mguentner/gaggia-cortex/case/ssr-cover.stl

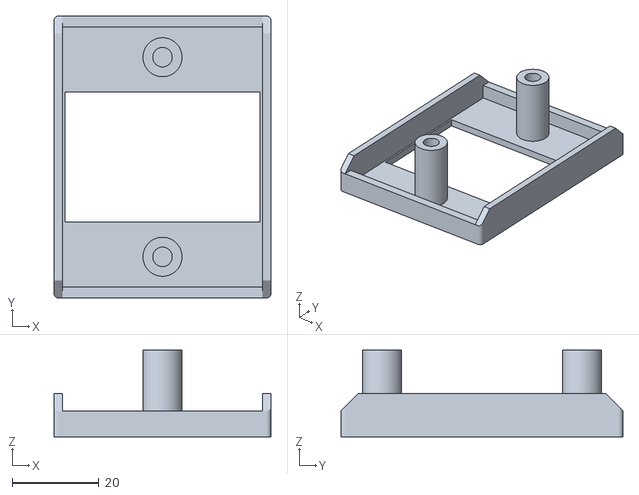
[picture p3: CAD file, 2024-03-08]
case/ssr-cover.stl
50.0 x 65.0 x 20.0
