mguentner/gaggia-cortex/case/case-Top.stl

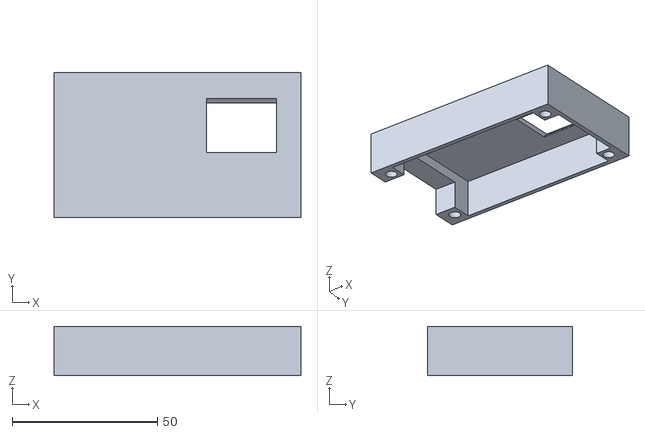
[picture p4: CAD file, 2024-03-08]
case/case-Top.stl
85.0 x 50.0 x 17.0
