mguentner/gaggia-cortex/case/case-Base.stl

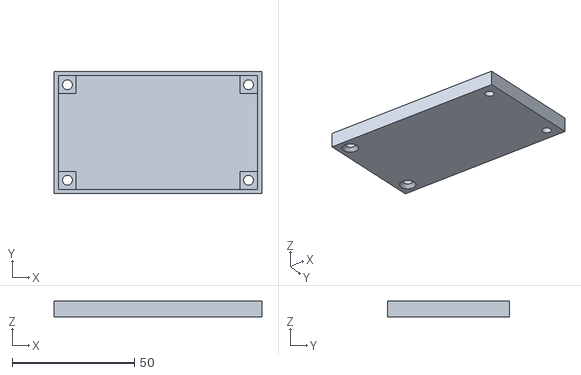
[picture p5: CAD file, 2024-03-08]
case/case-Base.stl
85.0 x 50.0 x 6.50
