mguentner/gaggia-cortex/case/case-Mount.stl

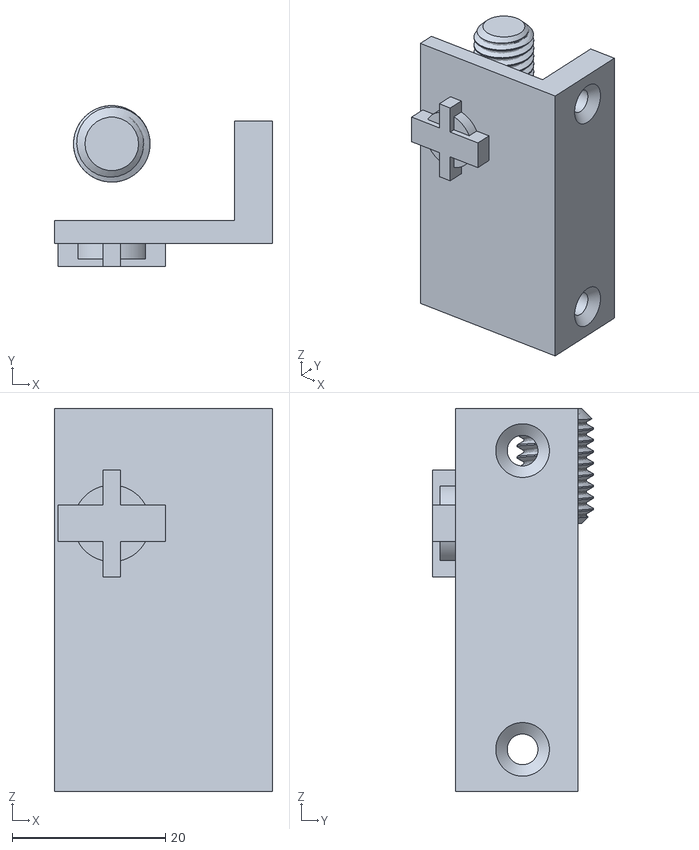
[picture p6: CAD file, 2024-03-08]
case/case-Mount.stl
28.5 x 21.0 x 50.0
