mguentner/gaggia-cortex/case/case.FCStd

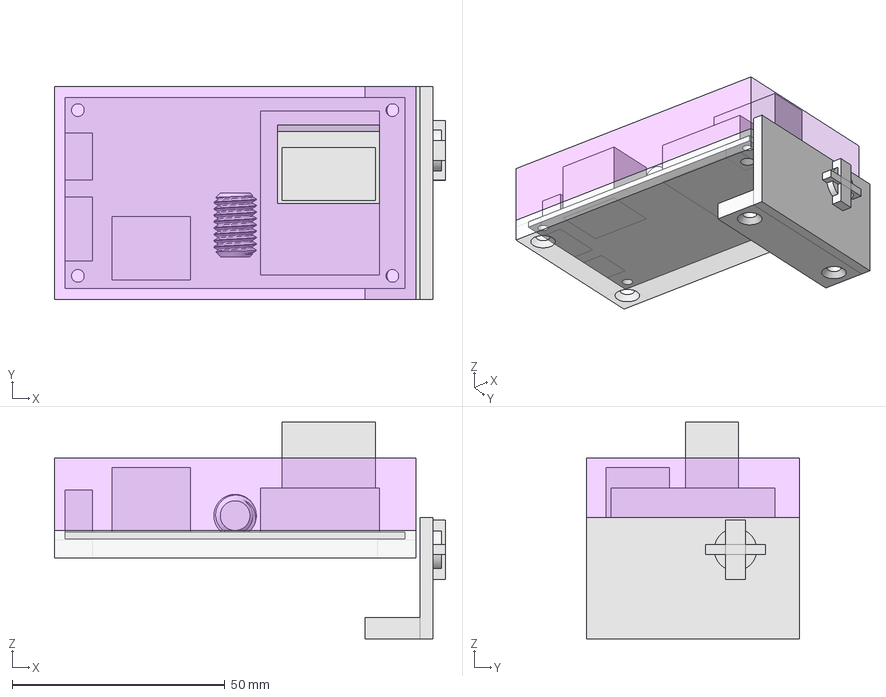
[picture p7: CAD file, 2024-03-08]
case/case.FCStd
92.0 x 50.0 x 51.0 mm
Base
Mainboard
Top
screw
M10x15-ThreadedRod
