mguentner/gaggia-cortex/case/case-Nut.stl

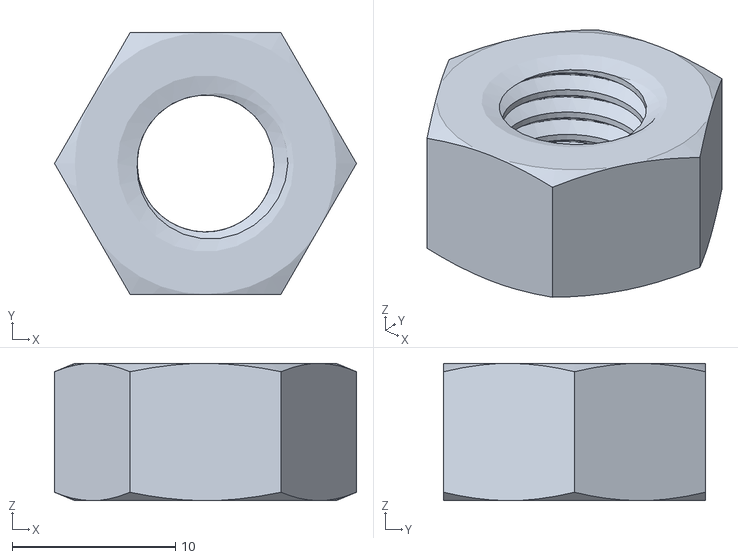
[picture p8: CAD file, 2024-03-08]
case/case-Nut.stl
18.5 x 16.0 x 8.40
