mguentner/gaggia-cortex/daughter_board/board.kicad_pcb

## KiCad design daughter_board/board.kicad_pcb (2024-01-12)

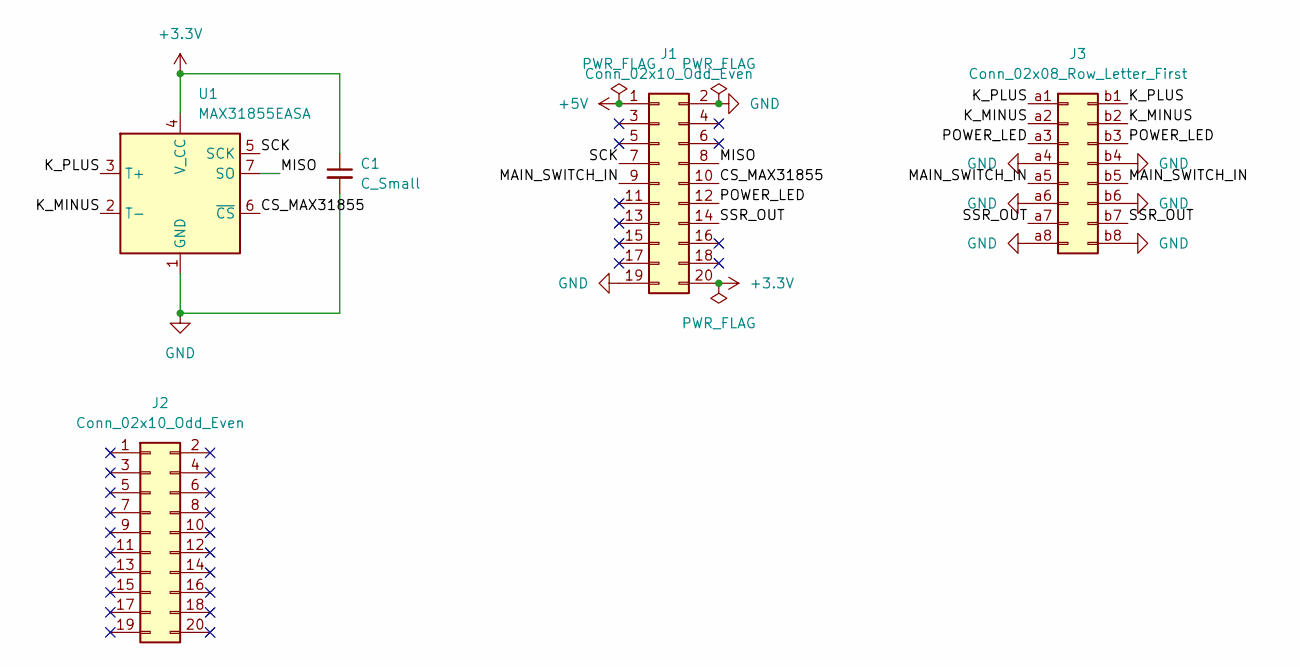
[picture p9: schematic board.kicad_sch]

Parts:
C1: C_Small; C_0603_1608Metric
J1, J2: Conn_02x10_Odd_Even; PinHeader_2x10_P2.54mm_Vertical
J3: Conn_02x08_Row_Letter_First; con-wago-233-508
U1: MAX31855EASA; SOIC-8_3.9x4.9mm_P1.27mm

Connections:
+3.3V: C1.1, J1.20, U1.4 (V_CC)
+5V: J1.1
/CS_MAX31855: J1.10, U1.6 (~CS)
/K_MINUS: J3.a2, J3.b2, U1.2 (T-)
/K_PLUS: J3.a1, J3.b1, U1.3 (T+)
/MAIN_SWITCH_IN: J1.9, J3.a5, J3.b5
/MISO: J1.8, U1.7 (SO)
/POWER_LED: J1.12, J3.a3, J3.b3
/SCK: J1.7, U1.5 (SCK)
/SSR_OUT: J1.14, J3.a7, J3.b7
GND: C1.2, J1.2, J1.19, J3.a4, J3.a6, J3.a8, J3.b4, J3.b6, J3.b8, U1.1 (GND)

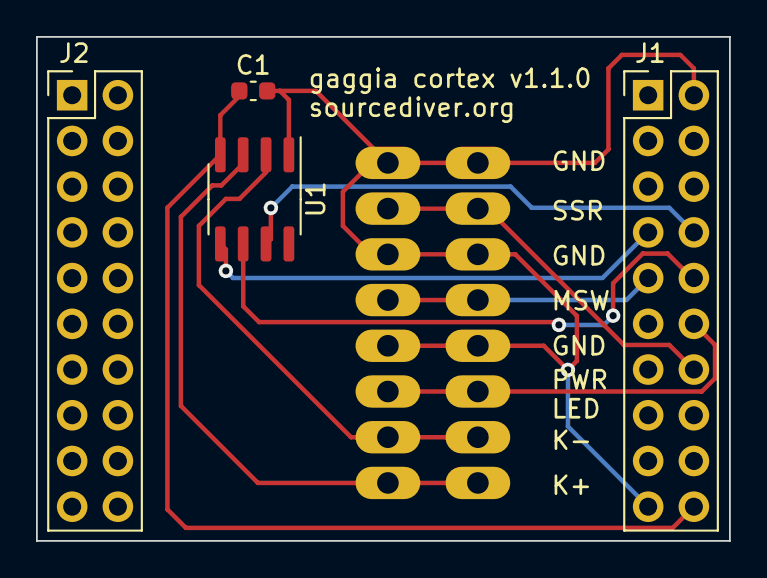
[picture p10: board board.kicad_pcb from above]

Board: 2 copper layers, 38.5 x 28.0 mm, 5 parts (1 on the bottom side), 10 nets.
