mguentner/gaggia-cortex/(commit log)

2024-01-12 add daughter board schematics
    [board-B_Cu.gbr, board-B_Mask.gbr, board-B_Silkscreen.gbr, board-Edge_Cuts.gbr, board-F_Cu.gbr, board-F_Mask.gbr, board-F_Silkscreen.gbr, board-NPTH.drl]
2024-01-12 add README for daughter board
2024-03-08 split config into base and switch/button files
2024-03-08 add case freecad file and .stl
    [case-Base.stl, case-Mount.stl, case-Nut.stl, case-Top.stl, case.FCStd]
2024-03-08 correct mount, add ssr cover
    [ssr-cover.stl]
2024-03-08 fix: add/enable captive portal if wifi connect fails
    [gaggia-cortex-base.yaml]
